kaiharten/baby3dscanner/docs/Onderzoek Stappenmotor.pdf

## 1. Stappenmotor

De onderzoeksvraag is: wat voor een soort stappen motor moet gebruikt worden, hoe kan deze worden encode? En wat voor een accu kan gebruikt worden voor het systeem?

Een stappenmotor heeft de unieke eigenschap dat een volledige rotatie wordt verdeeld in een aantal gelijke stappen, waarbij de hoekverdraaiing een vaste waarde heeft, bijvoorbeeld 1.8° of 0.9° per stap. De stappenmotor is een borstel loze motor.
Stappenmotoren leveren een relatief hoog koppel bij een laag toerental, zelfs bij totale stilstand. Dit alles maakt stappenmotoren zeer geschikt voor positioneerapplicaties met een laag toerental en hoog koppel. Daarnaast kunnen we een stappen motor ook in servo step mode toepassen, waarbij we nog steeds de genoemde specifieke voordelen behouden, zonder stappenverlies ook in het hoger toerenbereik, lagere temperatuur, et cetera. Er zijn 2 type stappenmotoren beschikbaar:

Unipolaire type
Een unipolaire stappenmotor heeft 2 wikkelingen met elk een midden aftakking en heeft dus 6 aansluitingen. De midden aftakkingen (common) worden permanent aan één kant van de voedingsspanning aangesloten. In sommige gevallen zijn beide common-aansluitingen verbonden heeft de motor maar vijf 5 aansluitdraden. De vier andere
aansluitdraden worden door de besturing steeds wel of niet met de andere kant van
de spanning verbonden.

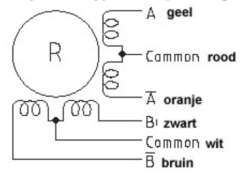
[picture p29: figure]

Figuur 1: Unipolair stappenmotor (Fraxeon, 2007)

Bipolaire type
Een bipolaire stappenmotor heeft 2 wikkelingen zonder midden aftakking en heeft dus 4 aansluitingen. Dit is momenteel het meest gangbare type motor.

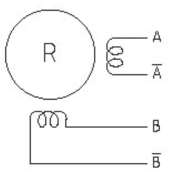
[picture p30: figure]

Figuur 2: Bipolair stappenmotor (Fraxeon, 2007)

1.1 Voordelen
- Hoog koppel bij laag toerental
- Robuust en betrouwbaar
- Eenvoudig toe te passen en aan te sturen
- Low-cost technology met enorme mogelijkheden

1.2 Nadelen
- Laag koppel bij hoog toerental
- Trillingen, deels te verhelpen door microstepping

2.0 Encoding

2.1 Rotary encoder

De goedkoopste manier om een stappenmotor te encoden is een rotary encoder. Rotary encoder ook wel de rotatie-meter genoemd, kan per omwenteling 20 pulsen. Hiermee kun je de uitlezen welke kant op en hoeveel de encoder is opgedraaid.

Toepassing: positiesensor of (digitale) frequentieregeling, volumeregeling enz. Of als control om door gegevens in een LCD te scrollen of een menu te maken met een LCD, data-selectie met een LED. (Hackerstore, 2018)

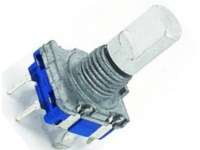
[picture p31: figure]

Figuur 3: Rotary encoder

De rotary encoder is makkelijk te programmeren en uit te lezen. Hieronder is een voorbeeld aansluiting te zien met een arduino en een rotary encoder.

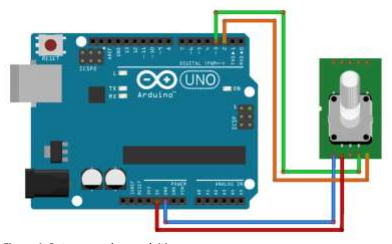
[picture p32: figure]

Figuur 4: Rotary encoder aansluiting

2.2 Stappenmotor encoder

De Makeblock-Me Encoder motor-driver V1 is als een voorbeeld genomen van de velen stappenmotor encoders die er zijn. De duurdere encoder Me Encoder motor-driver kan tot 2 stappenmotoren aansturen. De exacte snelheid en positie van 2 motoren kunnen worden ingesteld en gescheiden gehouden. De motor driver-IC is een TB6612, net als bij de Me Dual DC motor-driver. Deze encoder is speciaal gemaakt om een stappenmotor aan te sturen, met de rotary encoder moet mechanische gebouwd worden rondom de stappenmotor. (Makeblock, 2018)

Eigenschappen:

- Nauwkeurige instelling van snelheid en positie.
- Real-time terugmelding van positie en snelheid.
- TB6612PNG Motor Driver IC met zeer efficiënte op MOSFET gebaseerde H-brug.
- Arduino-bibliotheek voor eenvoudige programmering.
- Bereik motorvermogen 6 V tot 12 V.
- 1 A maximale continue stroom per motor.
- Overstroombeveiliging.
- Eenvoudige bedrading met RJ25 interface.
- 2,54 mm pennen voor de aansluiting aan Dubond-draden

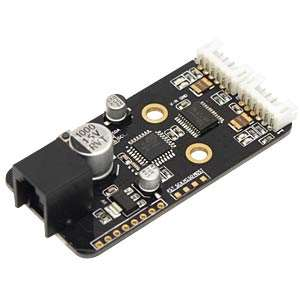
[picture p33: figure]

Figuur 5: Makeblock-Me Encoder motor-driver

## 3. voeding

Het is belangrijk om de goede accu en daarvoor ook de goede oplader voor te vinden. Daarvoor wordt er eerst onderzoek gedaan naar de accu/batterij en daarna naar het opladen hiervan. De soorten accu’s zijn in een lijst gezet, en daarnaast staan de eigenschappen, hoe de accu te laden is en waarop gelet moet worden.

Een batterij is eigenlijk een vat met twee metalen plaatjes (elektrodes), gevuld met een chemische stoffen. Deze stoffen bevatten elektrisch geladen ionen. Ionen zijn atomen die een elektrische lading hebben gekregen van (of afgegeven aan) elektronen. Afhankelijk van het soort batterij kunnen atomen bij de negatieve elektrode veranderen in positief geladen ionen. Het omgekeerde vindt plaats bij de positieve elektrode.

De batterij is te verdelen in 4 onderdelen:
- Een negatieve elektrode (anode): tijdens ontladen neemt de anode elektronen op van het externe circuit.
- Een positieve elektrode (kathode): tijdens ontladen geeft de kathode elektronen af aan het externe circuit.
- Een separator: scheidt de anode en de kathode van elkaar. Maar deze niet-geleidende kunststof strip (vaak folie) moet toch poreus zijn om elektronen en ionen door te kunnen laten.
- Elektrolyt: dit geleidend laagje (vaak vloeibaar) zorgt ervoor dat elektronen snel van de ene elektrode naar de andere elektrode kunnen vloeien. (MyMicro group, 2018)

Capaciteit “C “, aanduiding daarvoor is “Ah” (Ampère-uur) Dit is de mate waarin een accu belast kan worden in de tijd. “C = belasting maal de tijd.” (C wordt vaak uitgedrukt in mAH, 1000 mAh = 1 Ah. Als voorbeeld: heeft men een lampje met een vermogen van 3 watt en een accu van 6 Volt en 2 Ah dan kan men globaal gezien gedurende 4 uur dit lampje laten branden. 3 watt gedeeld door 6 Volt = 0,5 A. 2Ah gedeeld door 0,5 = 4 h (uur). Bij grotere stromen gat dit niet zondermeer op, zie het als een richtlijn. (MBVA, 2018)

Op de volgende bladzijde staat het tabel.

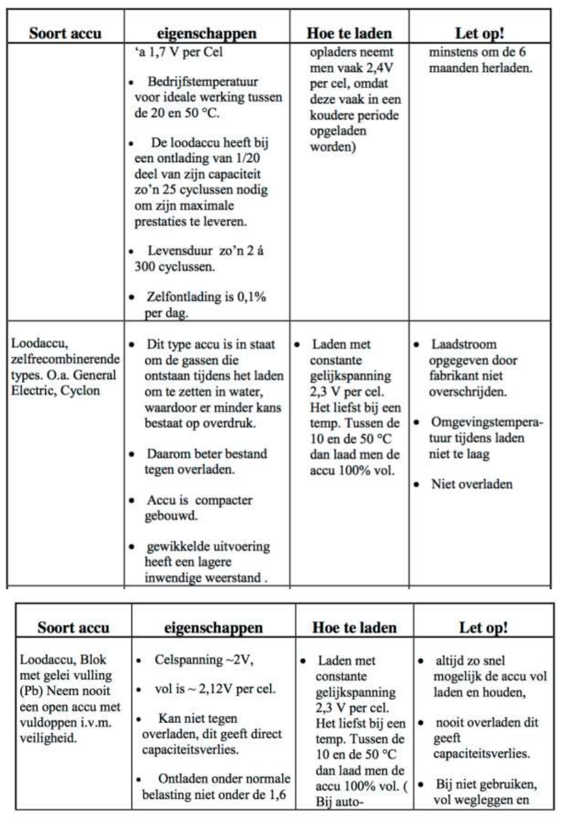
[picture p34: page 6]

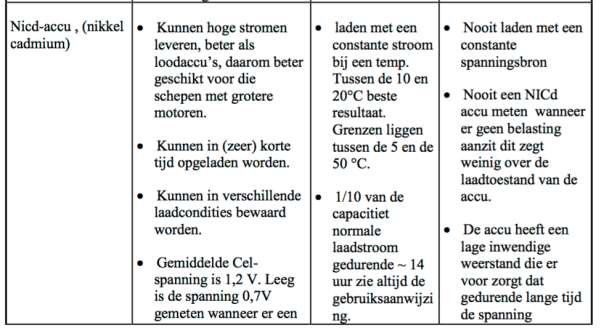
[picture p35: figure]
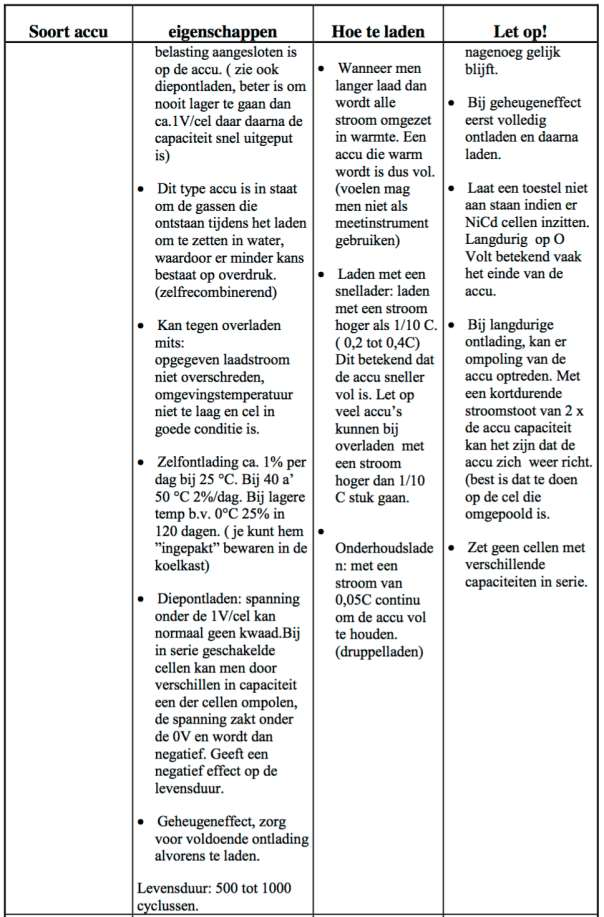
[picture p36: page 8]

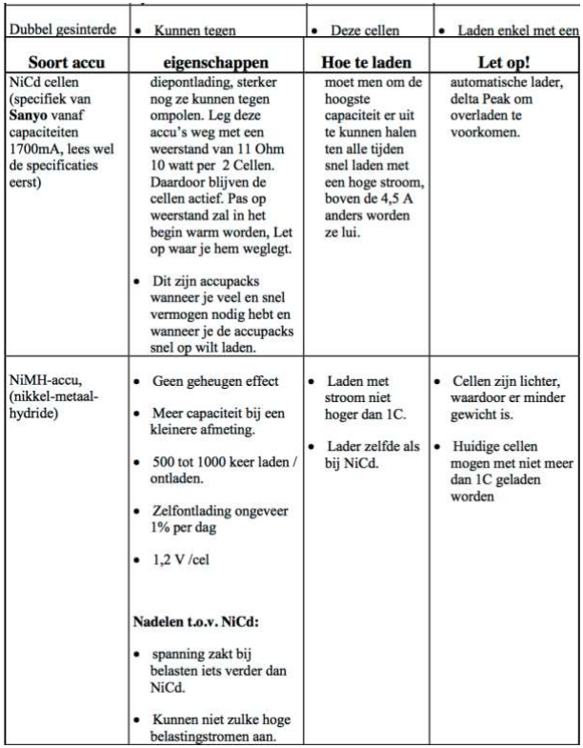
[picture p37: figure]
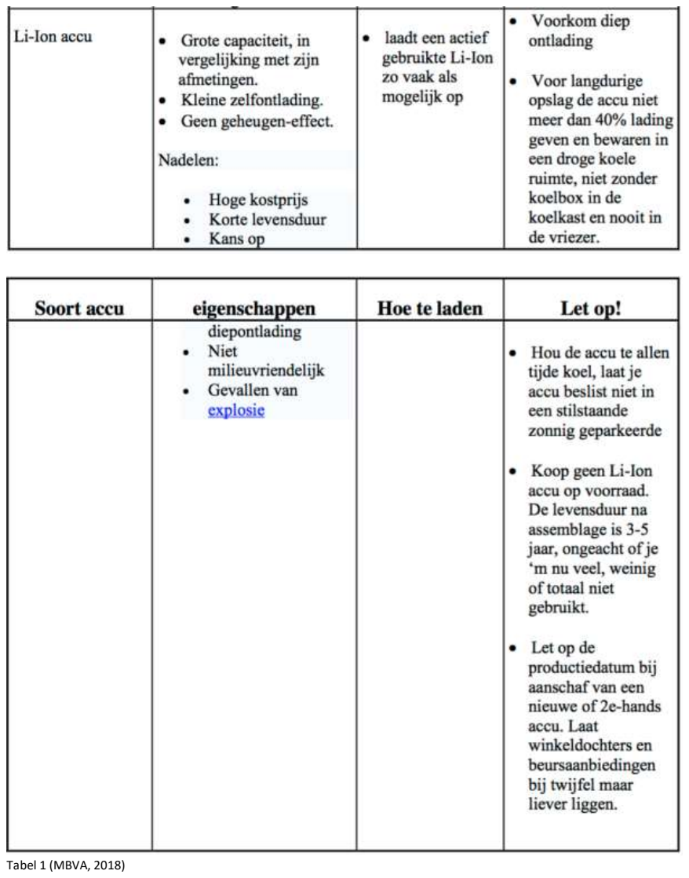
[picture p38: page 10]

Tabel 1 (MBVA, 2018)

Laden van de Accu: bij het laden van de accu moet gelet worden op de polariteit, niet elke lader is hiertegen beschermd. Tijdens het laden van de accu mag de accu niet worden losgekoppeld van de lader. Ook dit heeft een negatief resultaat op de levensduur. De accu moet volledig geladen zijn voordat deze losgekoppeld wordt. Een kant en klaar gekochte accu is opgebouwd uit gelijke cellen welke door de fabrikant geselecteerd zijn.

Bij een loodaccu is de laadspanning mede afhankelijk van de omgevingstemperatuur: Bij 20 graden Celsius is de benodigde aangelegde spanning 2,3V. Neem een acculader welke automatisch afschakelt bij het bereiken van de lading eindspanning 13,8 V.

Soorten Laders: Naast de verdeling constante gelijkspanningslader voor loodaccu’s en de constante gelijkstroom lader voor NiCd/NiMH cellen. Kan men de stroombronladers ook anders verdelen. Namelijk:

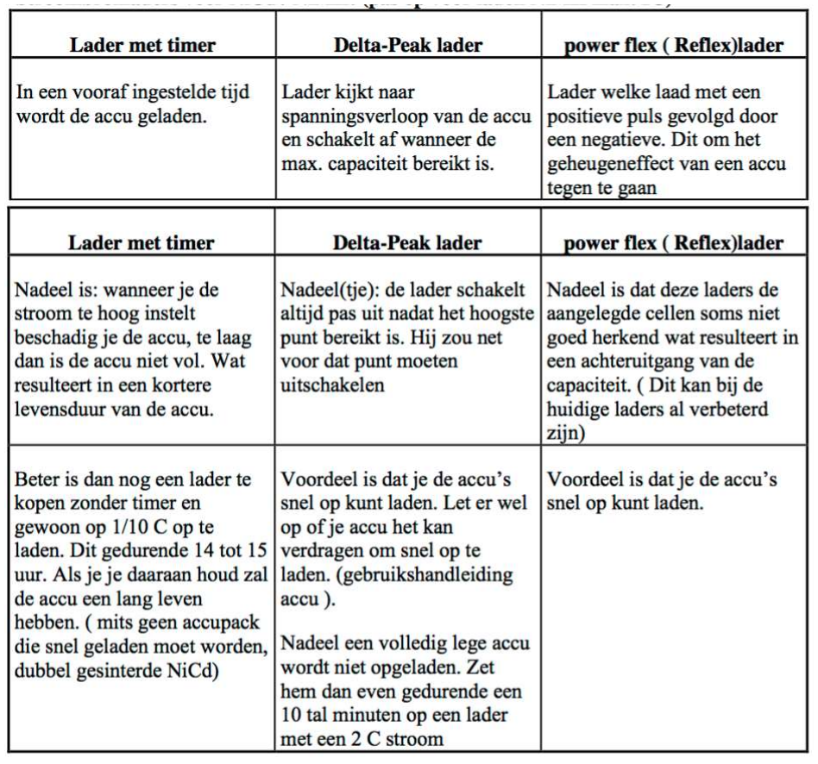
[picture p39: figure]

Tabel 2 (MBVA, 2018)

Waar ook aandacht op gevestigd moet worden is of er netspanning is om de accu op te laden of de accu opgeladen moet worden door een andere spanning. Indien dit zo is, moet er een andere oplossing worden bedacht.

Waar ook aan gedacht moet worden, is een lader waarbij je de stroom kunt aanpassen aan de capaciteit van de accu. Let er dan wel op dat je met 1/10 C van de accu laad gedurende ongeveer 14 uur. Dus neem een lader met een instelbare keuze van de stroom. Nadeel van een “niet zelf controlerende” lader is dat men een fout kan maken, waardoor je (dure) accu’s stuk kunnen gaan.

## 4 Conclusie

Uit onderzoek is gebleken dat de gebruikelijke bipolair stappenmotor gebruikt moet worden, omdat dit de meest gebruikelijke en verkrijgbare stappen motor is. De aanwezige stappenmotor nema 17 die op de frame is gemonteerd en die gebruikt moest worden, is een bipolair stappenmotor. De A4988 driver die aanwezig is, is ook een bipolair stappenmotor driver. Om zo nauwkeurig mogelijk te kunnen encoden zal de Makeblock-Me Encoder motor-driver kunnen worden gebruikt, maar de encoder gebruikt ook een rotary encoder. Omdat er al een motordriver aanwezig is, kan er een code worden geschreven voor de rotary encoder. Dit zal dan een goedkope en ook een betrouwbare oplossing zijn voor het encoden. Het kiezen van een accu is niet eenvoudig, als er een accu gekozen zal moeten worden zal die een groot genoeg capaciteit moeten hebben om 30 baby’s te moeten scannen. De scanner gebruikt in totaal ongeveer 800 mAh, een scan duurt ongeveer 5 minuten. Dat zal ongeveer 2,5 uur aan scans zijn. De ontlading van de accu is niet belangrijk, omdat het een keer per maand gebruikt zal worden. In onze project is er toch voor gekozen om geen accu te gebruiken, omdat het een prototype is. Er een adapter gekozen van 24 Volt.
