kaiharten/baby3dscanner/docs/img/2d_plot.jpeg

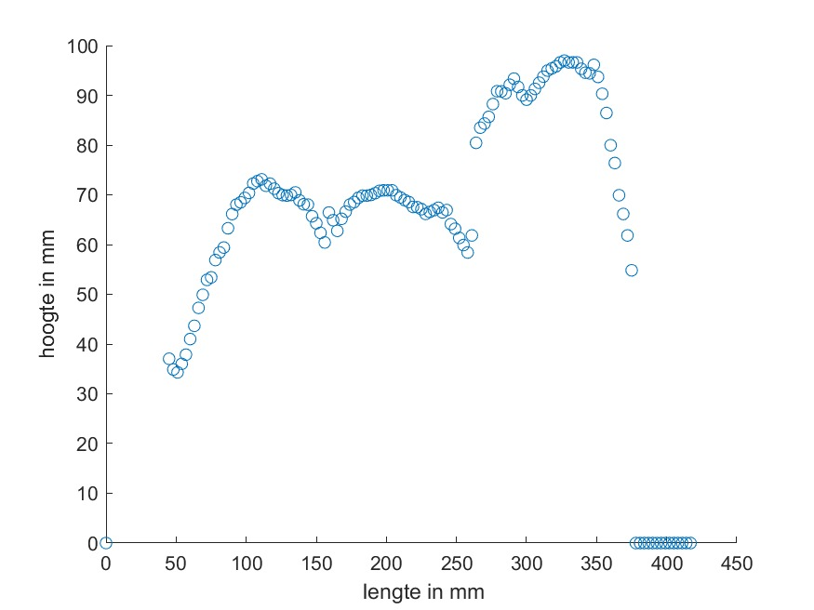
docs/img/2d_plot.jpeg
