kaiharten/baby3dscanner/baby3dscanner/camera.py

from threading import Thread, Lock
import cv2

class CameraStream:

    def __init__(self, src = 0, width = 1280, height = 720):
        self.stream = cv2.VideoCapture(src)
        self.stream.set(3, width)
        self.stream.set(4, height)
        (self.grabbed, self.frame) = self.stream.read()
        self.started = False
        self.read_lock = Lock()

    def start(self):
        if self.started:
            print ("Already started!")
            return None
        self.started = True
        self.thread = Thread(target=self.update, args=())
        self.thread.start()
        return self
    
    def update(self):
        while self.started:
            (grabbed, frame) = self.stream.read()
            self.read_lock.acquire()
            self.grabbed, self.frame = grabbed, frame
            self.read_lock.release()
    
    def read(self):
        self.read_lock.acquire()
        frame = self.frame.copy()
        self.read_lock.release()
        return frame
    
    def stop(self):
        self.started = False
        self.thread.join()

    def __exit__(self, exc_type, exc_value, traceback):
        self.stream.release()
