kaiharten/baby3dscanner/(commit log)

2018-03-16 Made test arduino sketch for folder structure
2018-03-16 Added needed arduino files
2018-06-24 added y in millimeters
2018-06-24 Fixed data bug x_laser
    [imageprocessor.py]
2018-06-25 Readme aangepast naar het nederlands
